ZatharV/ESD-F25-Final_Project/GamePal_PCB/GamePal_PCB_outline.pdf

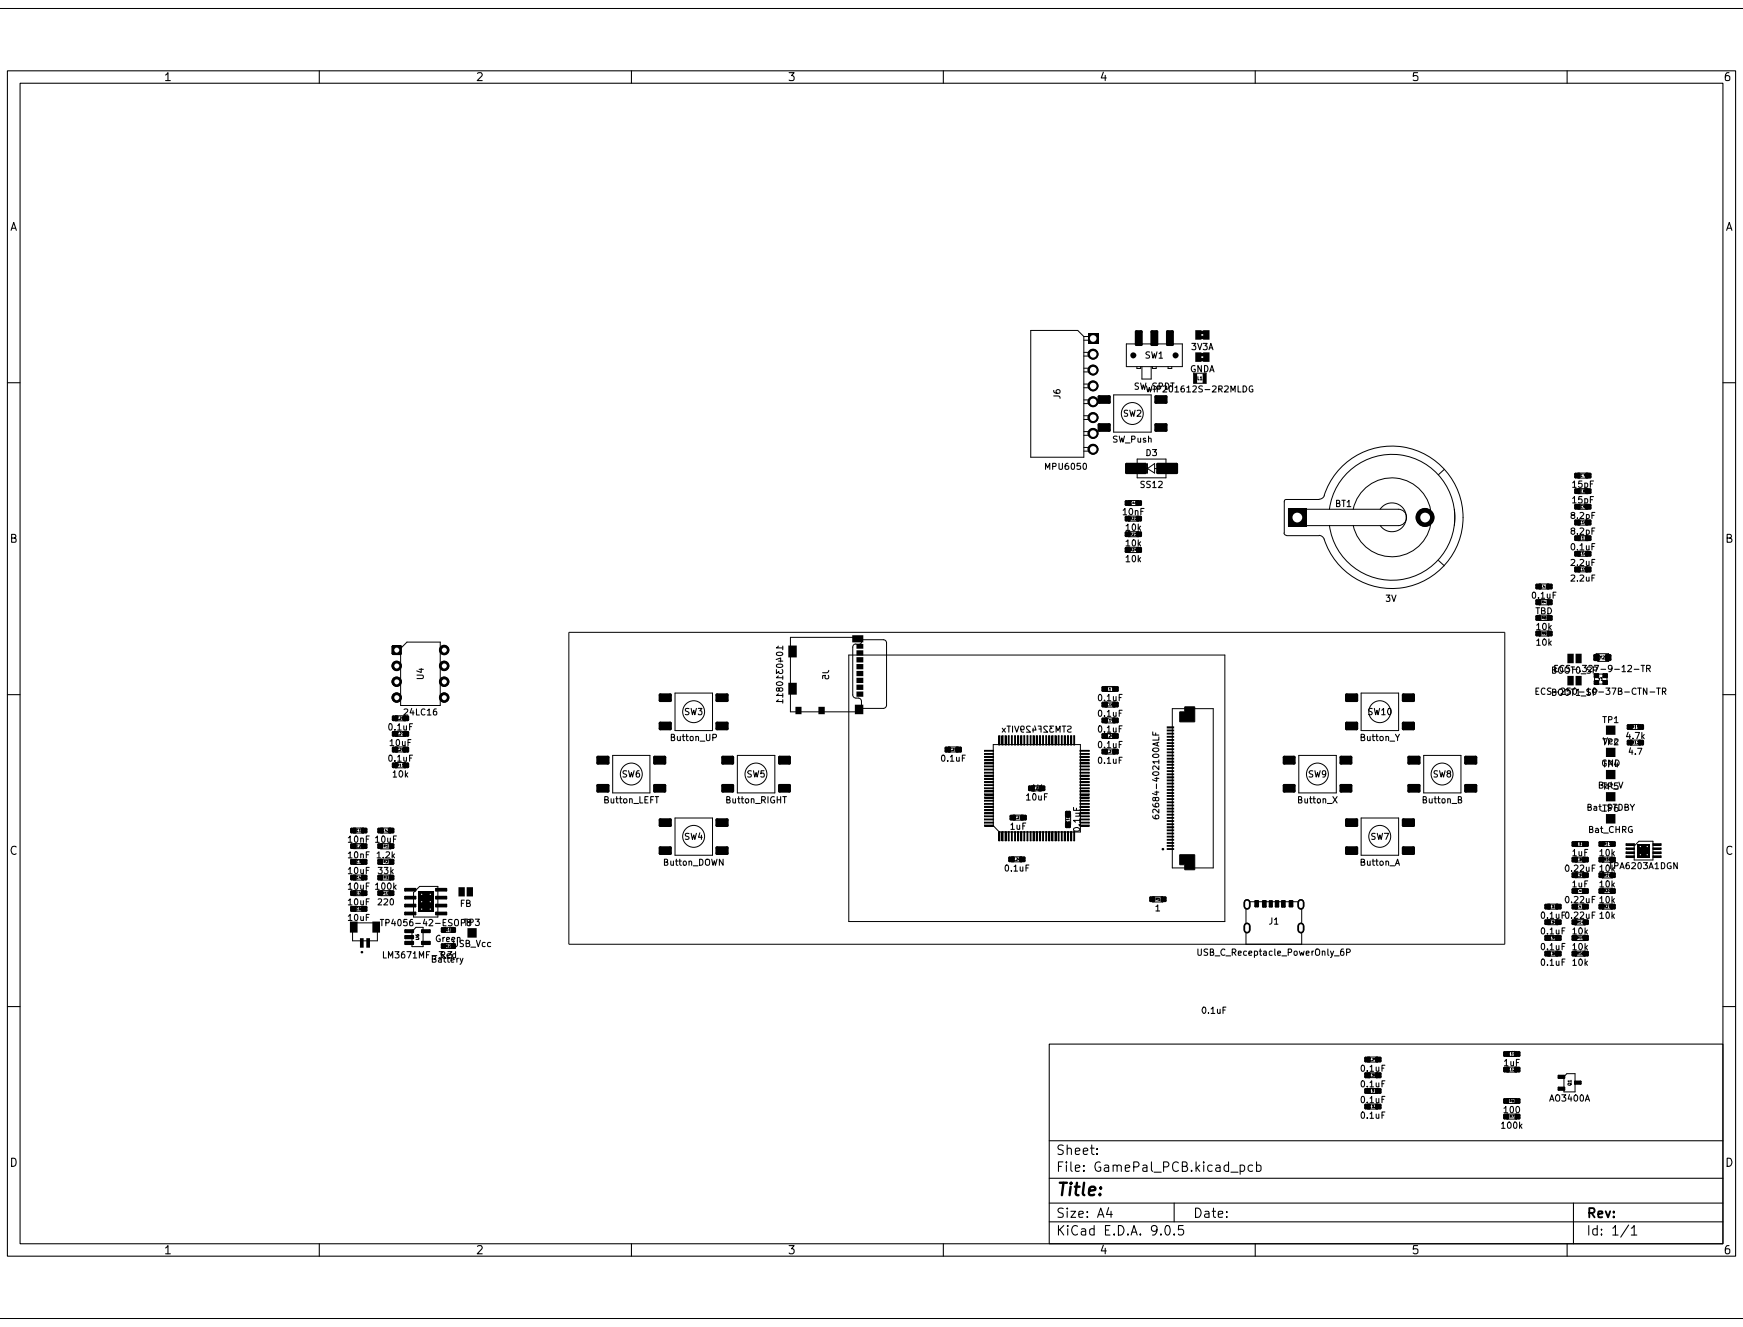
[picture p3: page 1]
