ZatharV/ESD-F25-Final_Project/GamePal_PCB/PDF/GamePal_PCB-Edge_Cuts.pdf

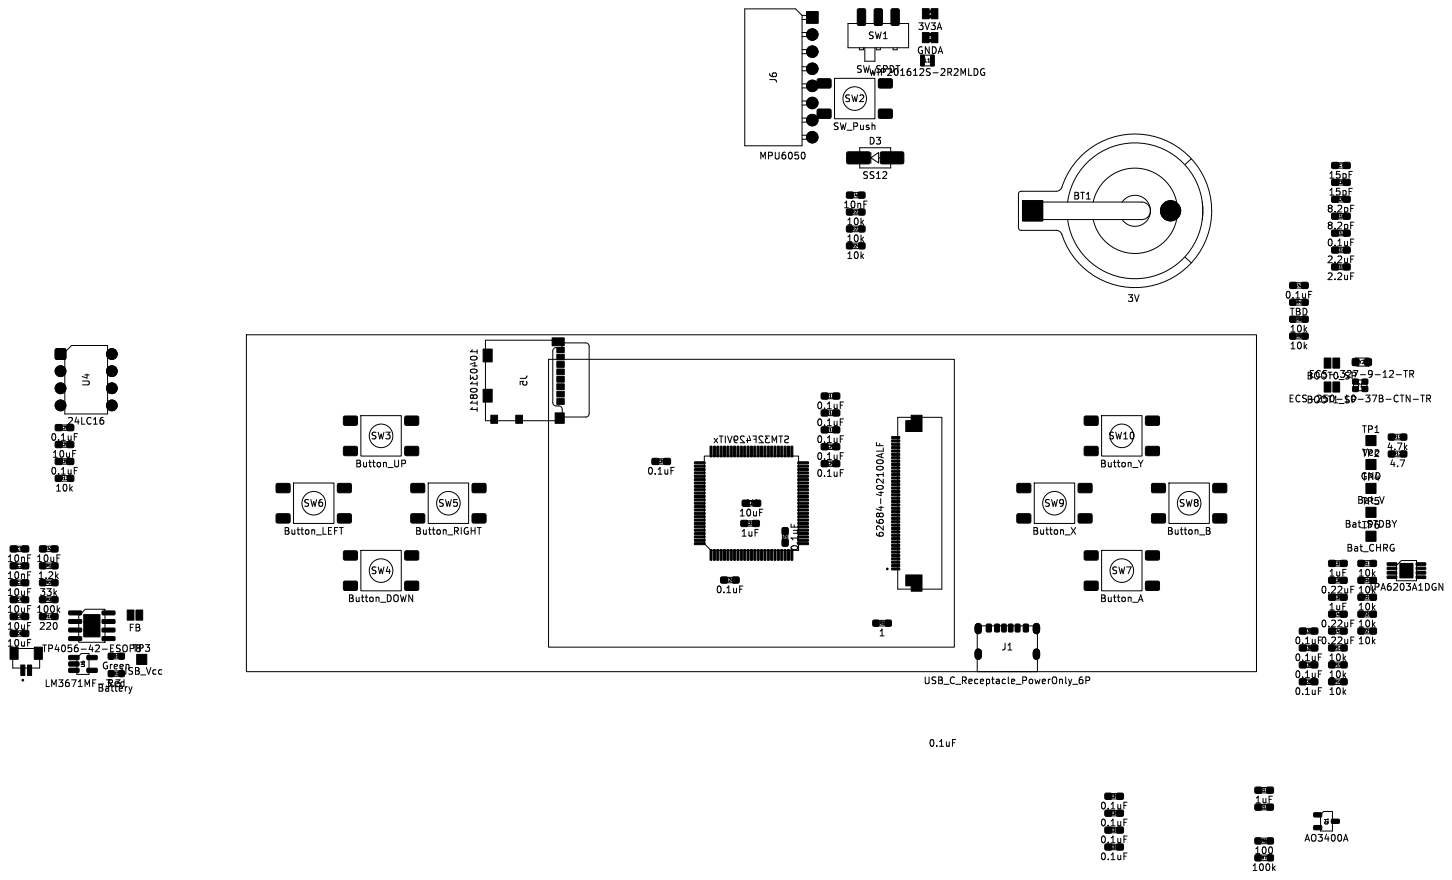
[picture p4: page 1]
