ZatharV/ESD-F25-Final_Project/GamePal_PCB/GamePal_PCB.kicad_pcb

## KiCad design GamePal_PCB/GamePal_PCB.kicad_pcb (2025-11-26)

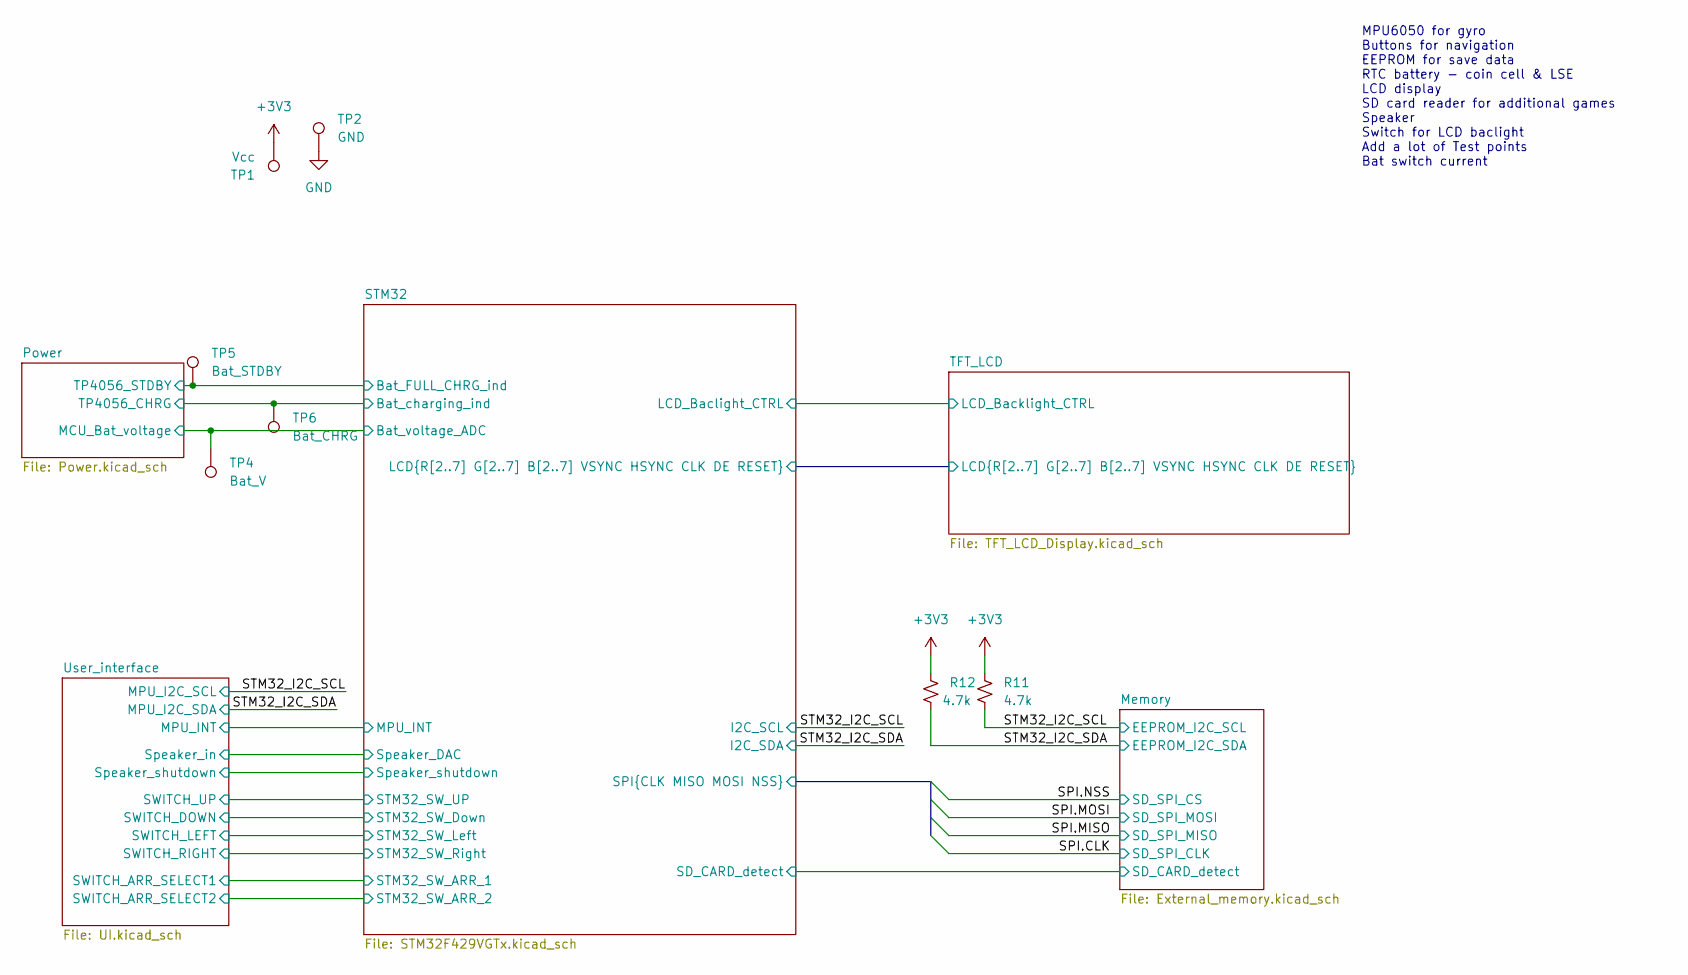
[picture p5: schematic GamePal_PCB.kicad_sch, GamePal]

Parts:
R11, R12: 4.7k; R_0603_1608Metric_Pad0.98x0.95mm_HandSolder
TP1: Vcc; TestPoint_Pad_1.5x1.5mm
TP2: GND; TestPoint_Pad_1.5x1.5mm
TP4: Bat_V; TestPoint_Pad_1.5x1.5mm
TP5: Bat_STDBY; TestPoint_Pad_1.5x1.5mm
TP6: Bat_CHRG; TestPoint_Pad_1.5x1.5mm

Connections:
+3V3: R11.1, R12.1, TP1.1; also elsewhere on the board
/Power/MCU_Bat_voltage: TP4.1; also elsewhere on the board
/Power/TP4056_CHRG: TP6.1; also elsewhere on the board
/Power/TP4056_STDBY: TP5.1; also elsewhere on the board
/STM32_I2C_SCL: R11.2; also elsewhere on the board
/STM32_I2C_SDA: R12.2; also elsewhere on the board
GND: TP2.1; also elsewhere on the board

Notes on the sheet:
MPU6050 for gyro Buttons for navigation EEPROM for save data RTC battery - coin cell & LSE LCD display SD card reader for additional games Speaker Switch for LCD baclight Add a lot of Test points Bat switch current

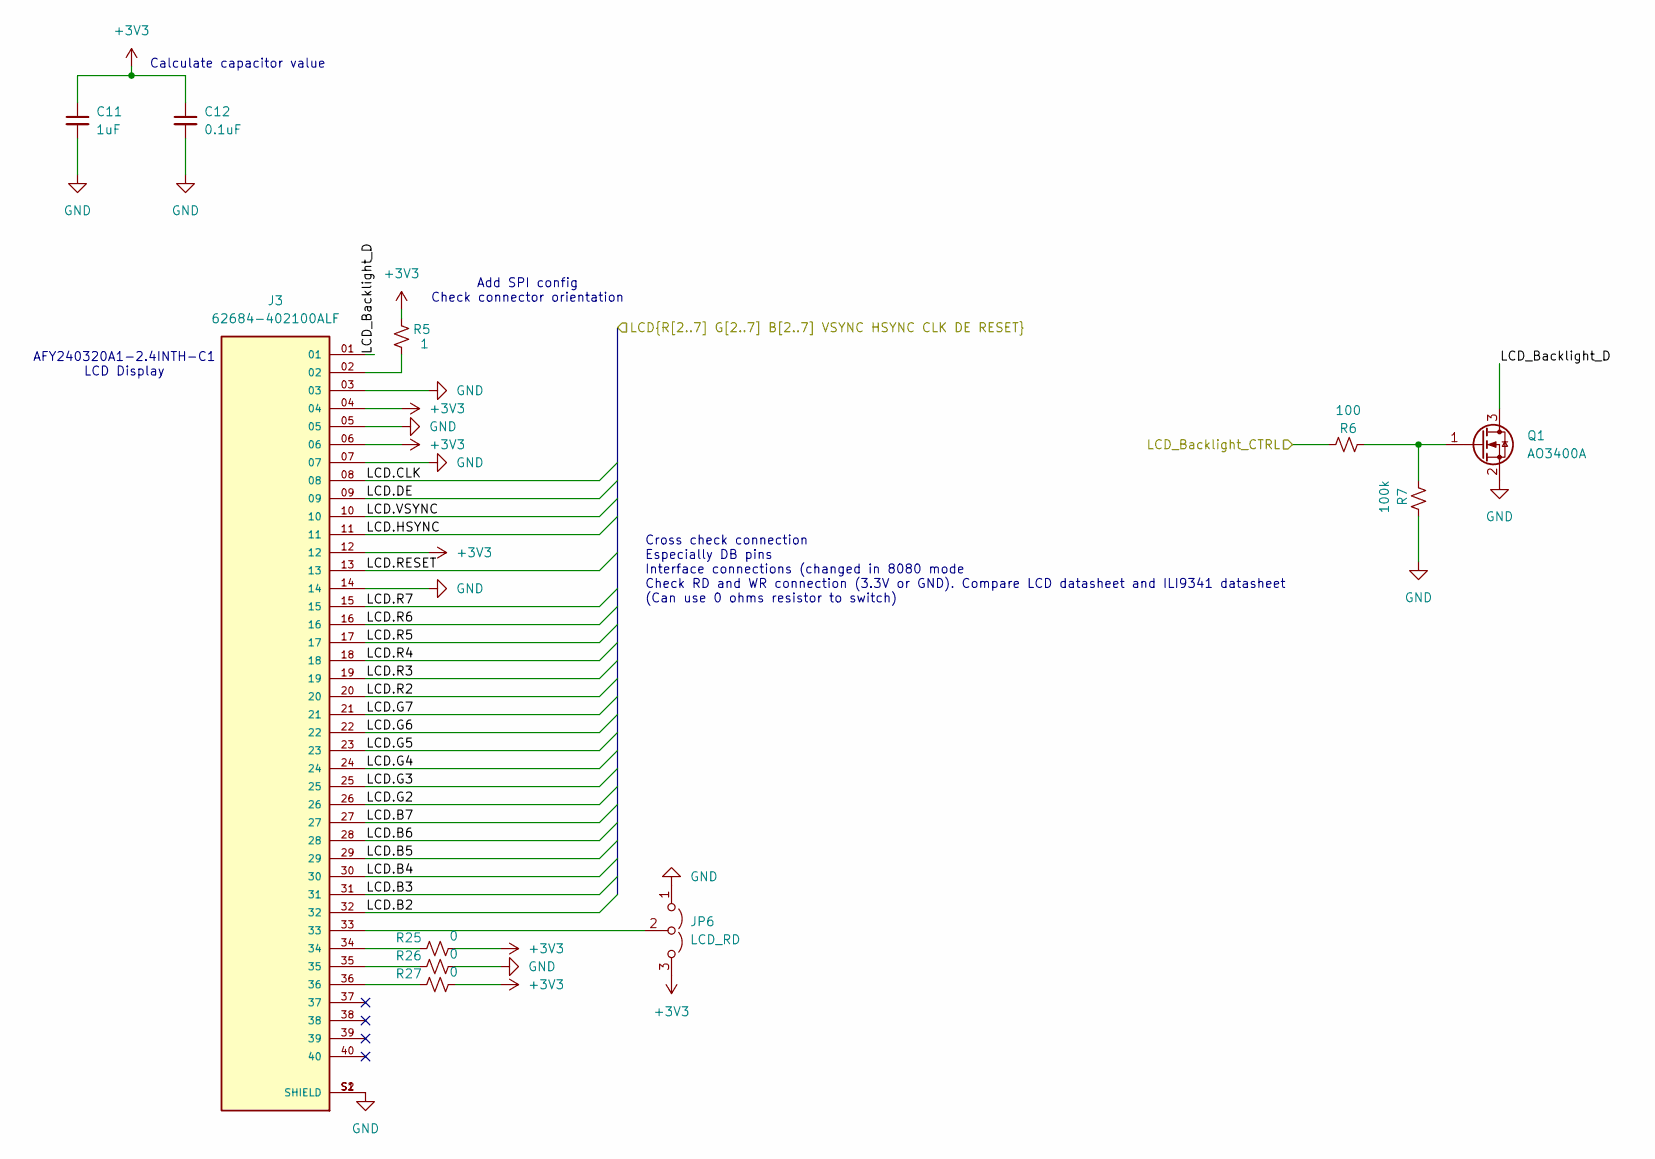
[picture p6: schematic TFT_LCD_Display.kicad_sch, GamePal]

Parts:
C11: 1uF; C_0603_1608Metric_Pad1.08x0.95mm_HandSolder
C12: 0.1uF; C_0603_1608Metric_Pad1.08x0.95mm_HandSolder
J3: 62684-402100ALF; AMPHENOL_62684-402100ALF; PARTREV AK
JP6: LCD_RD; SolderJumper-3_P1.3mm_Open_Pad1.0x1.5mm
Q1: AO3400A; TSOT-23
R5: 1; R_0603_1608Metric_Pad0.98x0.95mm_HandSolder
R6: 100; R_0603_1608Metric_Pad0.98x0.95mm_HandSolder
R7: 100k; R_0603_1608Metric_Pad0.98x0.95mm_HandSolder
R25, R26, R27: 0; R_0603_1608Metric_Pad0.98x0.95mm_HandSolder

Connections:
+3V3: C11.1, C12.1, J3.04, J3.06, J3.12, JP6.3 (B), R5.1, R25.2, R27.2; also elsewhere on the board
/STM32/LCD.B2: J3.32; also elsewhere on the board
/STM32/LCD.B3: J3.31; also elsewhere on the board
/STM32/LCD.B4: J3.30; also elsewhere on the board
/STM32/LCD.B5: J3.29; also elsewhere on the board
/STM32/LCD.B6: J3.28; also elsewhere on the board
/STM32/LCD.B7: J3.27; also elsewhere on the board
/STM32/LCD.CLK: J3.08; also elsewhere on the board
/STM32/LCD.DE: J3.09; also elsewhere on the board
/STM32/LCD.G2: J3.26; also elsewhere on the board
/STM32/LCD.G3: J3.25; also elsewhere on the board
/STM32/LCD.G4: J3.24; also elsewhere on the board
/STM32/LCD.G5: J3.23; also elsewhere on the board
/STM32/LCD.G6: J3.22; also elsewhere on the board
/STM32/LCD.G7: J3.21; also elsewhere on the board
/STM32/LCD.HSYNC: J3.11; also elsewhere on the board
/STM32/LCD.R2: J3.20; also elsewhere on the board
/STM32/LCD.R3: J3.19; also elsewhere on the board
/STM32/LCD.R4: J3.18; also elsewhere on the board
/STM32/LCD.R5: J3.17; also elsewhere on the board
/STM32/LCD.R6: J3.16; also elsewhere on the board
/STM32/LCD.R7: J3.15; also elsewhere on the board
/STM32/LCD.RESET: J3.13; also elsewhere on the board
/STM32/LCD.VSYNC: J3.10; also elsewhere on the board
/STM32/LCD_Baclight_CTRL: R6.1; also elsewhere on the board
/TFT_LCD/LCD_Backlight_D: J3.01, Q1.3 (D)
GND: C11.2, C12.2, J3.03, J3.05, J3.07, J3.14, J3.S1 (SHIELD), J3.S2 (SHIELD), JP6.1 (A), Q1.2 (S), R7.1, R26.2; also elsewhere on the board
unnamed: J3.02, R5.2
unnamed: J3.34, R25.1
unnamed: J3.35, R26.1
unnamed: J3.36, R27.1
unnamed: J3.33, JP6.2 (C)
unnamed: Q1.1 (G), R6.2, R7.2

Notes on the sheet:
AFY240320A1-2.4INTH-C1 LCD Display
Cross check connection Especially DB pins Interface connections (changed in 8080 mode Check RD and WR connection (3.3V or GND). Compare LCD datasheet and ILI9341 datasheet (Can use 0 ohms resistor to switch)
Add SPI config Check connector orientation
Calculate capacitor value

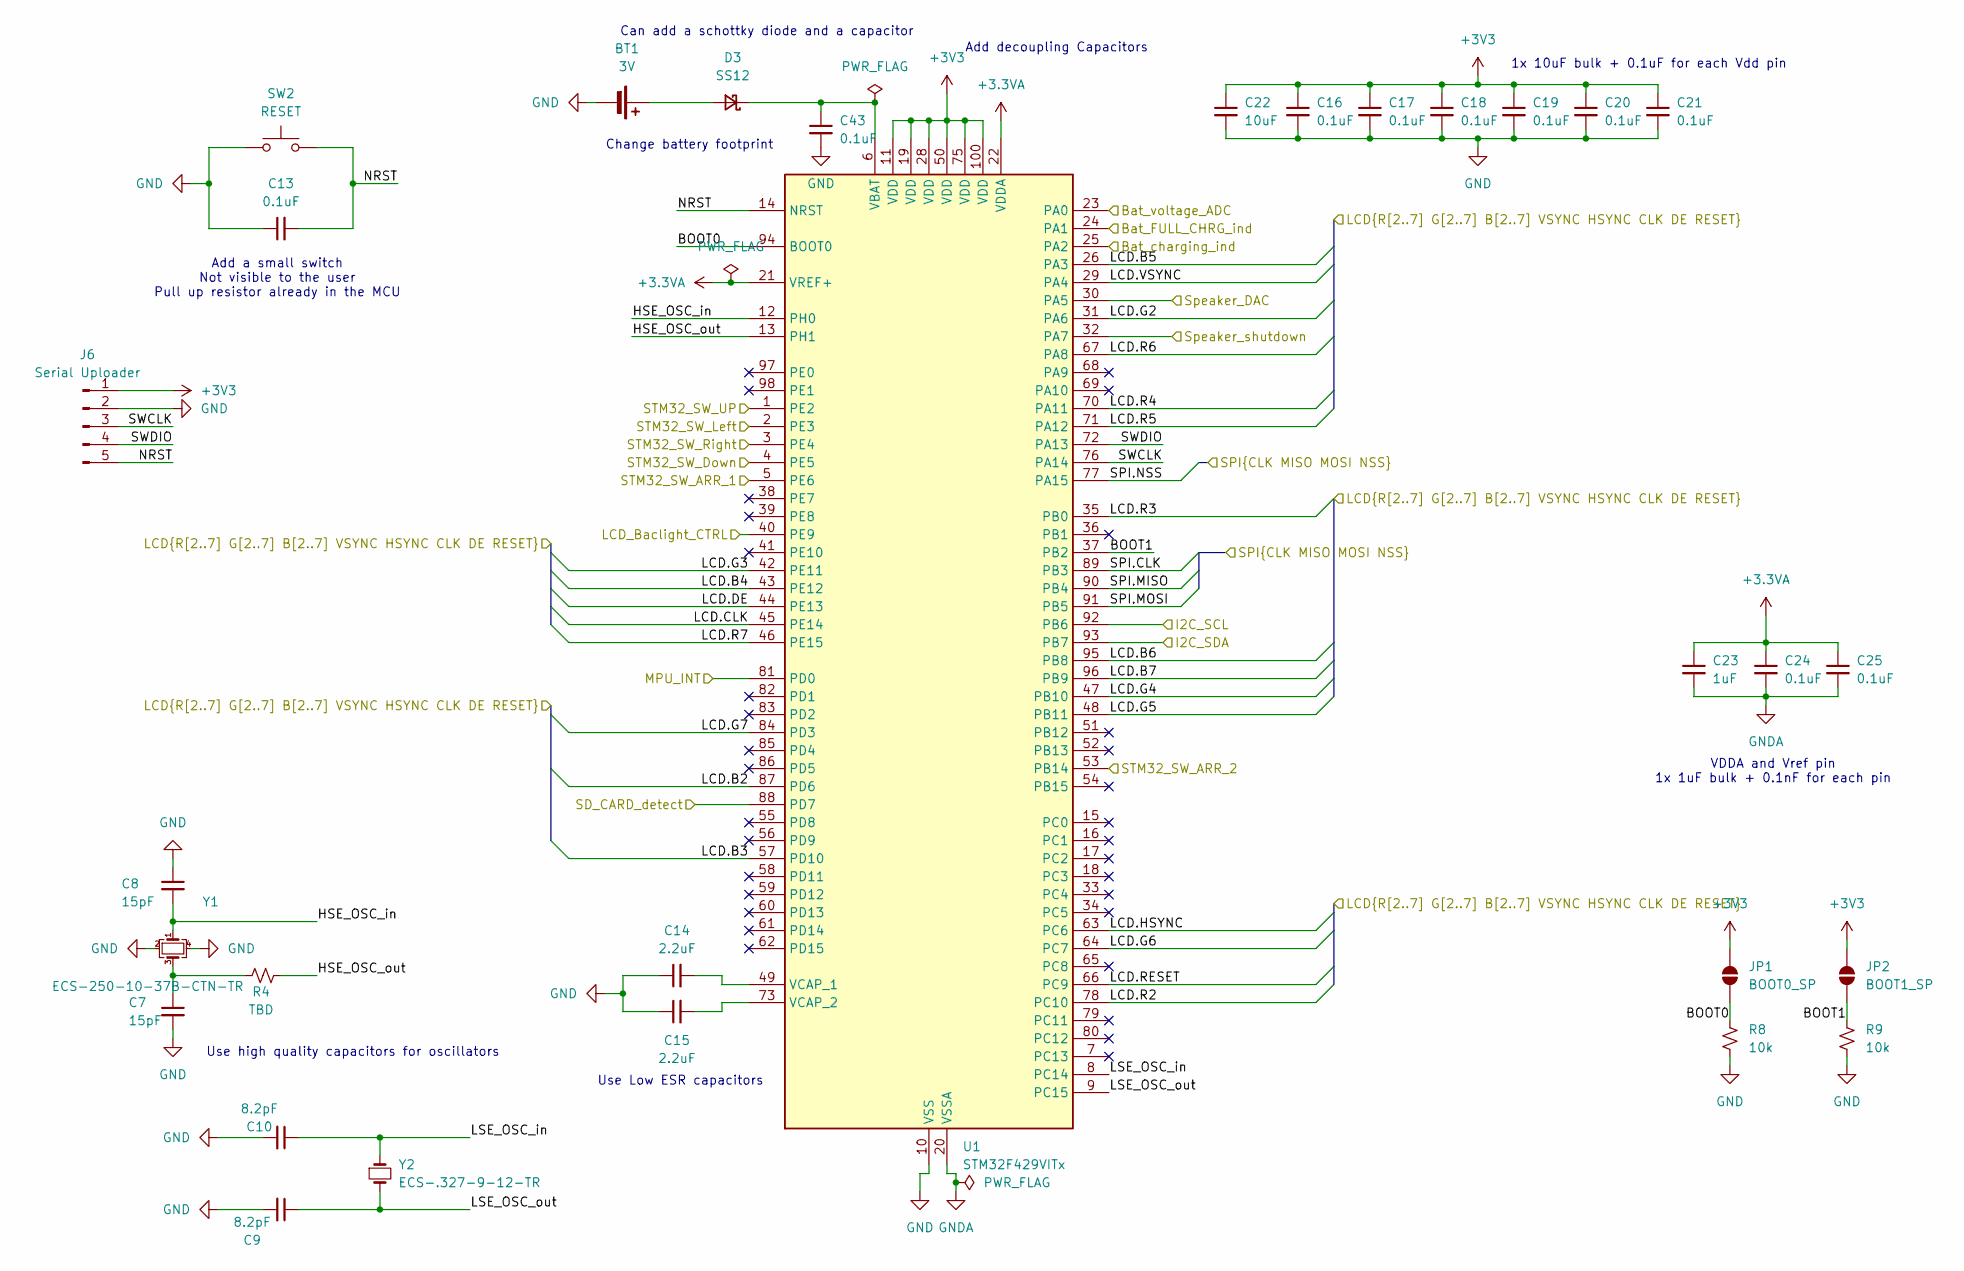
[picture p7: schematic STM32F429VGTx.kicad_sch, GamePal]

Parts:
BT1: 3V; BatteryHolder_Seiko_MS621F
C7, C8: 15pF; C_0603_1608Metric_Pad1.08x0.95mm_HandSolder
C9, C10: 8.2pF; C_0603_1608Metric_Pad1.08x0.95mm_HandSolder
C13, C16, C17, C18, C19, C20, C21, C24, C25, C43: 0.1uF; C_0603_1608Metric_Pad1.08x0.95mm_HandSolder
C14, C15: 2.2uF; C_0603_1608Metric_Pad1.08x0.95mm_HandSolder
C22: 10uF; C_0603_1608Metric_Pad1.08x0.95mm_HandSolder
C23: 1uF; C_0603_1608Metric_Pad1.08x0.95mm_HandSolder
D3: SS12; D_SMA
J6: Serial Uploader; PinHeader_1x05_P2.54mm_Vertical_SMD_Pin1Right
JP1: BOOT0_SP; SolderJumper-2_P1.3mm_Open_Pad1.0x1.5mm
JP2: BOOT1_SP; SolderJumper-2_P1.3mm_Open_Pad1.0x1.5mm
R4: TBD; R_0603_1608Metric_Pad0.98x0.95mm_HandSolder
R8, R9: 10k; R_0603_1608Metric_Pad0.98x0.95mm_HandSolder
SW2: RESET; SW_Push_1P1T_NO_CK_KMR2
U1: STM32F429VITx; LQFP-100_14x14mm_P0.5mm
Y1: ECS-250-10-37B-CTN-TR; Crystal_SMD_2016-4Pin_2.0x1.6mm
Y2: ECS-.327-9-12-TR; Crystal_SMD_2012-2Pin_2.0x1.2mm_HandSoldering

Connections:
+3.3VA: C23.1, C24.1, C25.1, U1.21 (VREF+), U1.22 (VDDA); also elsewhere on the board
+3V3: C16.1, C17.1, C18.1, C19.1, C20.1, C21.1, C22.1, J6.1, JP1.2 (B), JP2.2 (B), U1.11 (VDD), U1.19 (VDD), U1.28 (VDD), U1.50 (VDD), U1.75 (VDD), U1.100 (VDD); also elsewhere on the board
/Memory/SD_CARD_detect: U1.88 (PD7); also elsewhere on the board
/Power/MCU_Bat_voltage: U1.23 (PA0); also elsewhere on the board
/Power/TP4056_CHRG: U1.25 (PA2); also elsewhere on the board
/Power/TP4056_STDBY: U1.24 (PA1); also elsewhere on the board
/STM32/BOOT0: JP1.1 (A), R8.1, U1.94 (BOOT0)
/STM32/BOOT1: JP2.1 (A), R9.1, U1.37 (PB2)
/STM32/HSE_OSC_in: C8.2, U1.12 (PH0), Y1.1
/STM32/HSE_OSC_out: R4.1, U1.13 (PH1)
/STM32/LCD.B2: U1.87 (PD6); also elsewhere on the board
/STM32/LCD.B3: U1.57 (PD10); also elsewhere on the board
/STM32/LCD.B4: U1.43 (PE12); also elsewhere on the board
/STM32/LCD.B5: U1.26 (PA3); also elsewhere on the board
/STM32/LCD.B6: U1.95 (PB8); also elsewhere on the board
/STM32/LCD.B7: U1.96 (PB9); also elsewhere on the board
/STM32/LCD.CLK: U1.45 (PE14); also elsewhere on the board
/STM32/LCD.DE: U1.44 (PE13); also elsewhere on the board
/STM32/LCD.G2: U1.31 (PA6); also elsewhere on the board
/STM32/LCD.G3: U1.42 (PE11); also elsewhere on the board
/STM32/LCD.G4: U1.47 (PB10); also elsewhere on the board
/STM32/LCD.G5: U1.48 (PB11); also elsewhere on the board
/STM32/LCD.G6: U1.64 (PC7); also elsewhere on the board
/STM32/LCD.G7: U1.84 (PD3); also elsewhere on the board
/STM32/LCD.HSYNC: U1.63 (PC6); also elsewhere on the board
/STM32/LCD.R2: U1.78 (PC10); also elsewhere on the board
/STM32/LCD.R3: U1.35 (PB0); also elsewhere on the board
/STM32/LCD.R4: U1.70 (PA11); also elsewhere on the board
/STM32/LCD.R5: U1.71 (PA12); also elsewhere on the board
/STM32/LCD.R6: U1.67 (PA8); also elsewhere on the board
/STM32/LCD.R7: U1.46 (PE15); also elsewhere on the board
/STM32/LCD.RESET: U1.66 (PC9); also elsewhere on the board
/STM32/LCD.VSYNC: U1.29 (PA4); also elsewhere on the board
/STM32/LCD_Baclight_CTRL: U1.40 (PE9); also elsewhere on the board
/STM32/LSE_OSC_in: C10.1, U1.8 (PC14), Y2.1
/STM32/LSE_OSC_out: C9.1, U1.9 (PC15), Y2.2
/STM32/MPU_INT: U1.81 (PD0); also elsewhere on the board
/STM32/NRST: C13.2, J6.5, SW2.2, U1.14 (NRST)
/STM32/SPI.CLK: U1.89 (PB3); also elsewhere on the board
/STM32/SPI.MISO: U1.90 (PB4); also elsewhere on the board
/STM32/SPI.MOSI: U1.91 (PB5); also elsewhere on the board
/STM32/SPI.NSS: U1.77 (PA15); also elsewhere on the board
/STM32/STM32_SW_ARR_1: U1.5 (PE6); also elsewhere on the board
/STM32/STM32_SW_ARR_2: U1.53 (PB14); also elsewhere on the board
/STM32/STM32_SW_Down: U1.4 (PE5); also elsewhere on the board
/STM32/STM32_SW_Left: U1.2 (PE3); also elsewhere on the board
/STM32/STM32_SW_Right: U1.3 (PE4); also elsewhere on the board
/STM32/STM32_SW_UP: U1.1 (PE2); also elsewhere on the board
/STM32/SWCLK: J6.3, U1.76 (PA14)
/STM32/SWDIO: J6.4, U1.72 (PA13)
/STM32/Speaker_DAC: U1.30 (PA5); also elsewhere on the board
/STM32/Speaker_shutdown: U1.32 (PA7); also elsewhere on the board
/STM32_I2C_SCL: U1.92 (PB6); also elsewhere on the board
/STM32_I2C_SDA: U1.93 (PB7); also elsewhere on the board
GND: BT1.2 (-), C7.2, C8.1, C9.2, C10.2, C13.1, C14.1, C15.1, C16.2, C17.2, C18.2, C19.2, C20.2, C21.2, C22.2, C43.2, J6.2, R8.2, R9.2, SW2.1, U1.10 (VSS), U1.27 (VSS), U1.74 (VSS), U1.99 (VSS), Y1.2, Y1.4; also elsewhere on the board
GNDA: C23.2, C24.2, C25.2, U1.20 (VSSA); also elsewhere on the board
unnamed: BT1.1 (+), D3.2 (A)
unnamed: C7.1, R4.2, Y1.3
unnamed: C43.1, D3.1 (K), U1.6 (VBAT)
unnamed: C14.2, U1.49 (VCAP_1)
unnamed: C15.2, U1.73 (VCAP_2)

Notes on the sheet:
1x 10uF bulk + 0.1uF for each Vdd pin
Use Low ESR capacitors
VDDA and Vref pin 1x 1uF bulk + 0.1nF for each pin
Can add a schottky diode and a capacitor
Add a small switch Not visible to the user Pull up resistor already in the MCU
Use high quality capacitors for oscillators
Change battery footprint
Add decoupling Capacitors

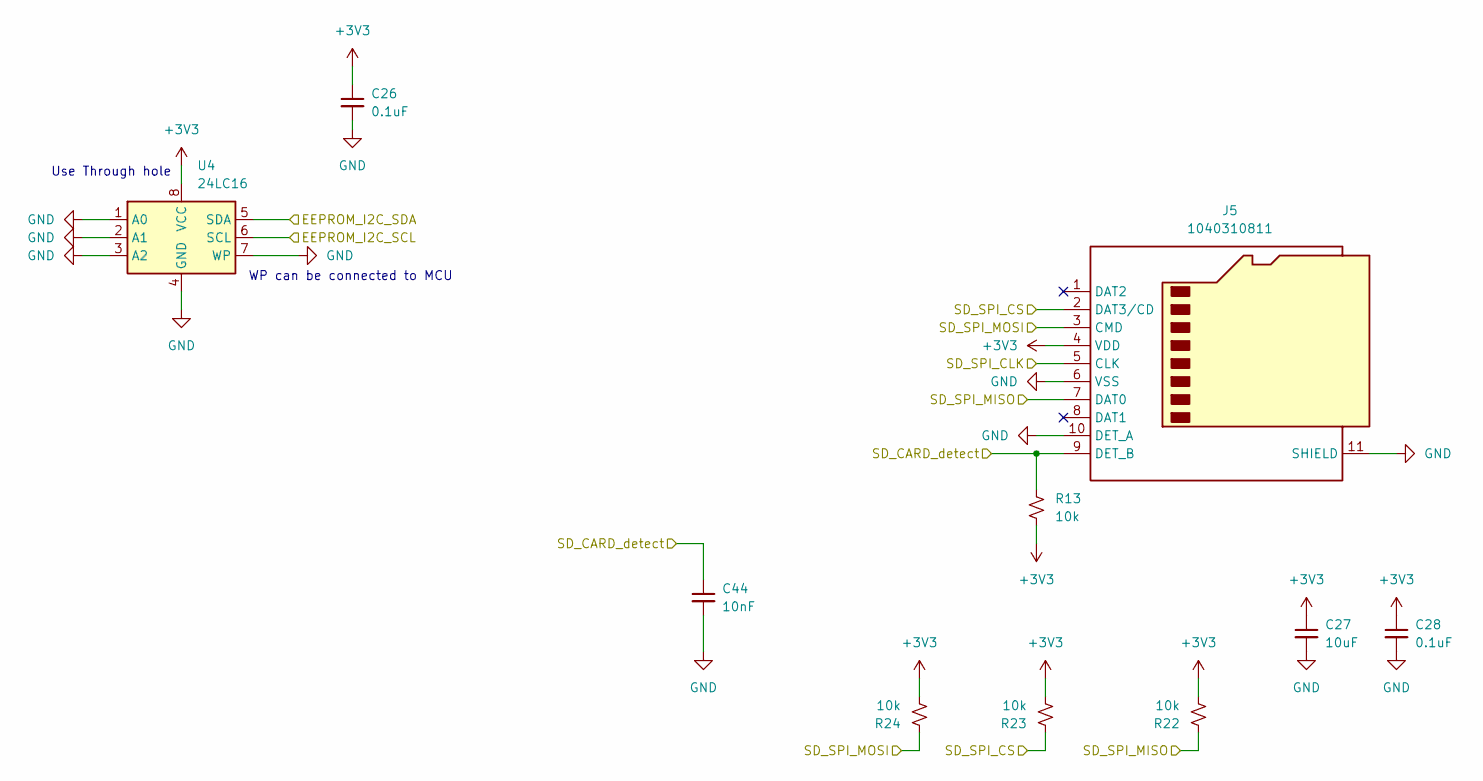
[picture p8: schematic External_memory.kicad_sch, GamePal]

Parts:
C26, C28: 0.1uF; C_0603_1608Metric_Pad1.08x0.95mm_HandSolder
C27: 10uF; C_0603_1608Metric_Pad1.08x0.95mm_HandSolder
C44: 10nF; C_0603_1608Metric_Pad1.08x0.95mm_HandSolder
J5: 1040310811; microSD_HC_Molex_104031-0811
R13, R22, R23, R24: 10k; R_0603_1608Metric_Pad0.98x0.95mm_HandSolder
U4: 24LC16; DIP-8_W7.62mm

Connections:
+3V3: C26.1, C27.1, C28.1, J5.4 (VDD), R13.1, R22.1, R23.1, R24.1, U4.8 (VCC); also elsewhere on the board
/Memory/SD_CARD_detect: C44.1, J5.9 (DET_B), R13.2; also elsewhere on the board
/STM32/SPI.CLK: J5.5 (CLK); also elsewhere on the board
/STM32/SPI.MISO: J5.7 (DAT0), R22.2; also elsewhere on the board
/STM32/SPI.MOSI: J5.3 (CMD), R24.2; also elsewhere on the board
/STM32/SPI.NSS: J5.2 (DAT3/CD), R23.2; also elsewhere on the board
/STM32_I2C_SCL: U4.6 (SCL); also elsewhere on the board
/STM32_I2C_SDA: U4.5 (SDA); also elsewhere on the board
GND: C26.2, C27.2, C28.2, C44.2, J5.6 (VSS), J5.10 (DET_A), J5.11 (SHIELD), U4.1 (A0), U4.2 (A1), U4.3 (A2), U4.4 (GND), U4.7 (WP); also elsewhere on the board

Notes on the sheet:
WP can be connected to MCU
Use Through hole

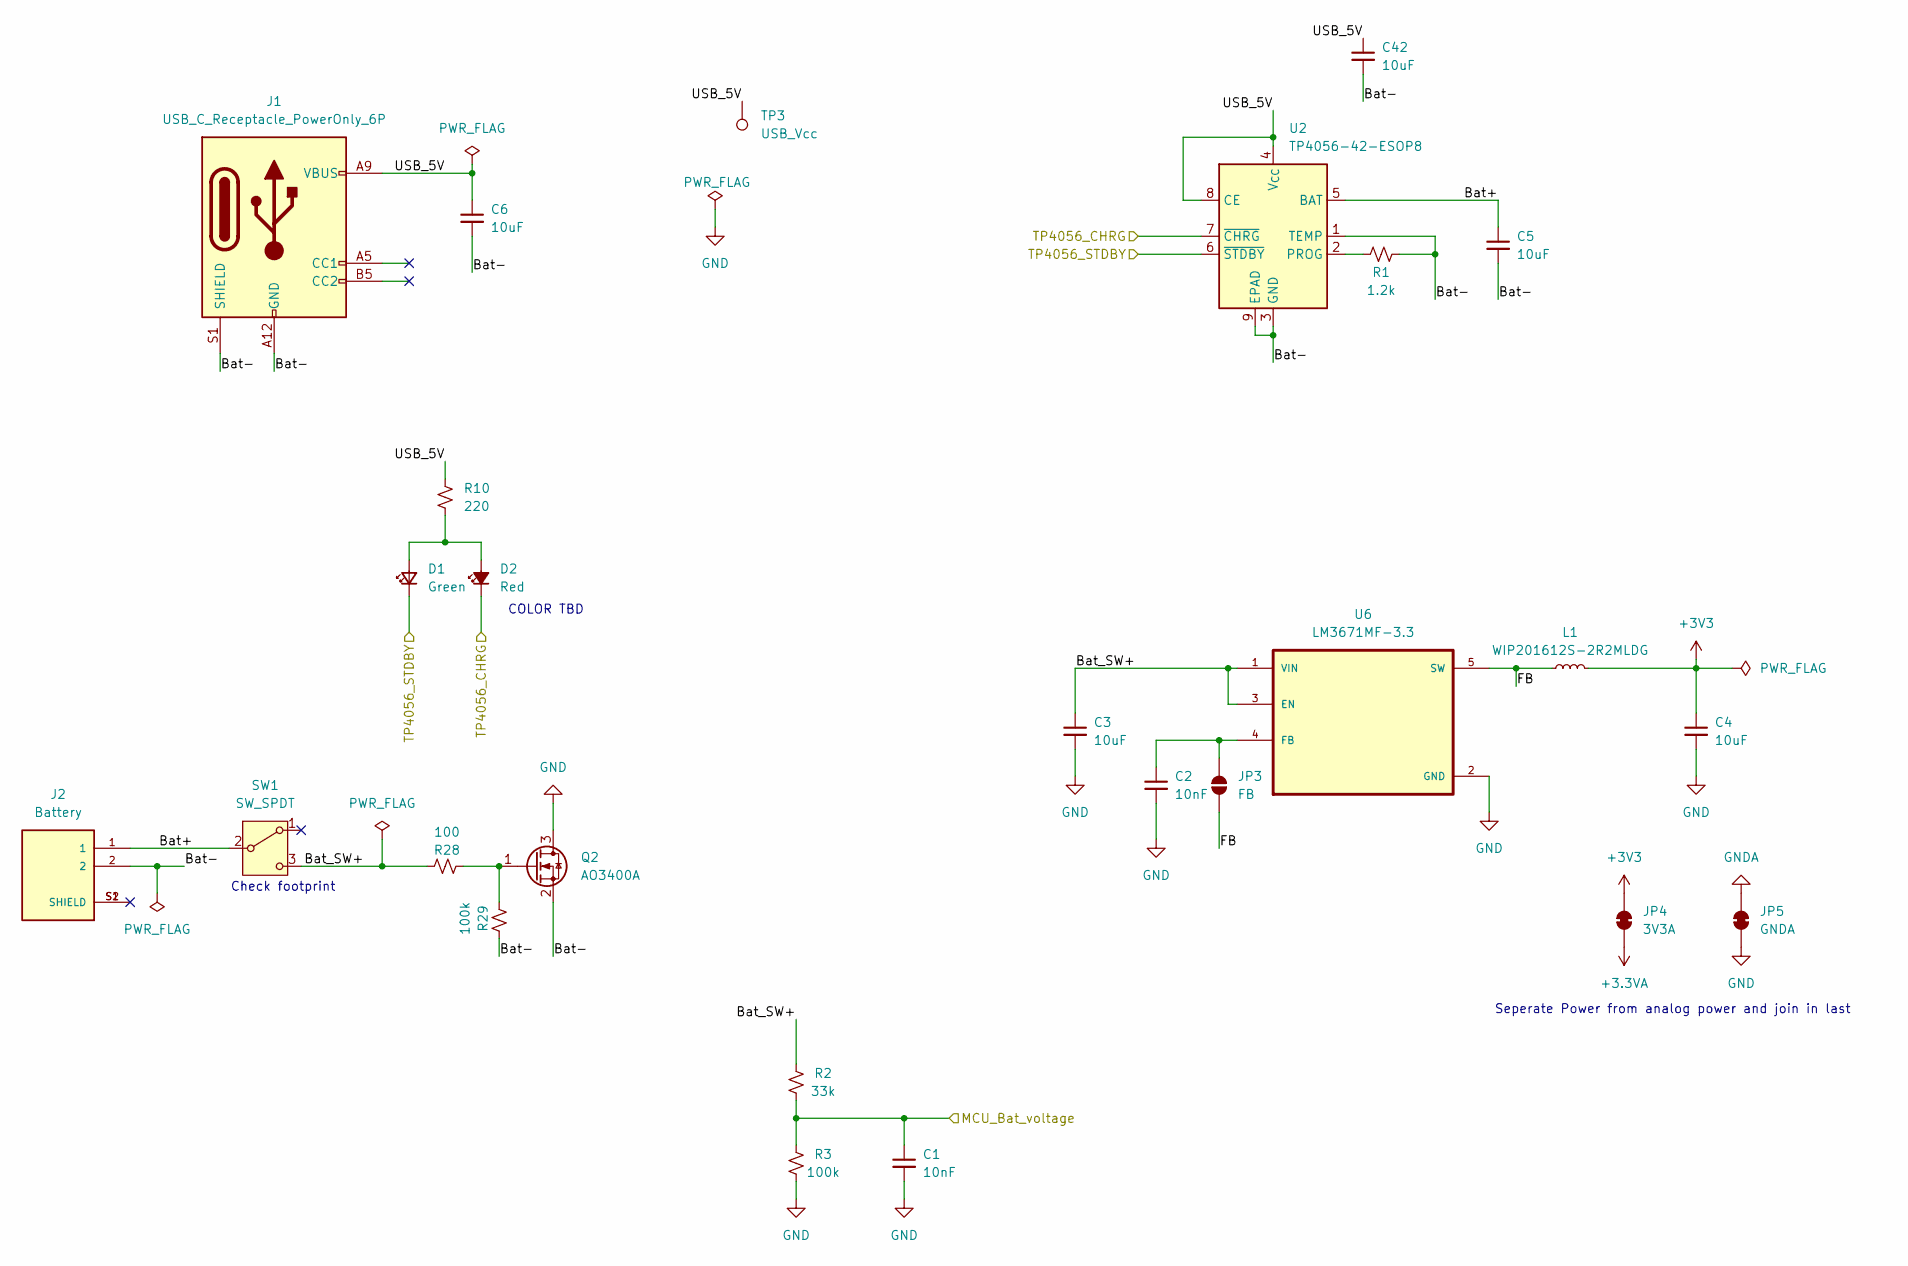
[picture p9: schematic Power.kicad_sch, GamePal]

Parts:
C1, C2: 10nF; C_0603_1608Metric_Pad1.08x0.95mm_HandSolder
C3, C4, C5, C6, C42: 10uF; C_0603_1608Metric_Pad1.08x0.95mm_HandSolder
D1: Green; LED_0603_1608Metric
D2: Red; LED_0603_1608Metric
J1: USB_C_Receptacle_PowerOnly_6P; USB_C_Receptacle_GCT_USB4125-xx-x_6P_TopMnt_Horizontal
J2: Battery; JST_BM02B-SRSS-TB_LF__SN_; PARTREV N/A
JP3: FB; SolderJumper-2_P1.3mm_Open_Pad1.0x1.5mm
JP4: 3V3A; SolderJumper-2_P1.3mm_Bridged2Bar_Pad1.0x1.5mm
JP5: GNDA; SolderJumper-2_P1.3mm_Bridged2Bar_Pad1.0x1.5mm
L1: WIP201612S-2R2MLDG; L_Murata_DFE201610P
Q2: AO3400A; TSOT-23
R1: 1.2k; R_0603_1608Metric_Pad0.98x0.95mm_HandSolder
R2: 33k; R_0603_1608Metric_Pad0.98x0.95mm_HandSolder
R3, R29: 100k; R_0603_1608Metric_Pad0.98x0.95mm_HandSolder
R10: 220; R_0603_1608Metric_Pad0.98x0.95mm_HandSolder
R28: 100; R_0603_1608Metric_Pad0.98x0.95mm_HandSolder
SW1: SW_SPDT; SW_SPDT_CK_JS102011SAQN
TP3: USB_Vcc; TestPoint_Pad_1.5x1.5mm
U2: TP4056-42-ESOP8; MSOP-8-1EP_3x3mm_P0.65mm_EP1.95x2.15mm
U6: LM3671MF-3.3; SOT-23-5_HandSoldering

Connections:
+3.3VA: JP4.1 (A); also elsewhere on the board
+3V3: C4.1, JP4.2 (B), L1.2; also elsewhere on the board
/Power/Bat+: C5.1, J2.1, SW1.2 (B), U2.5 (BAT)
/Power/Bat-: C5.2, C6.2, C42.2, J1.A12 (GND), J1.B12 (GND), J1.S1 (SHIELD), J2.2, Q2.2 (S), R1.1, R29.1, U2.1 (TEMP), U2.3 (GND), U2.9 (EPAD)
/Power/Bat_SW+: C3.1, R2.1, R28.1, SW1.3 (C), U6.1 (VIN), U6.3 (EN)
/Power/FB: JP3.1 (A), L1.1, U6.5 (SW)
/Power/MCU_Bat_voltage: C1.1, R2.2, R3.1; also elsewhere on the board
/Power/TP4056_CHRG: D2.1 (K), U2.7 (~CHRG); also elsewhere on the board
/Power/TP4056_STDBY: D1.1 (K), U2.6 (~STDBY); also elsewhere on the board
/Power/USB_5V: C6.1, C42.1, J1.A9 (VBUS), J1.B9 (VBUS), R10.1, TP3.1, U2.4 (V_{CC}), U2.8 (CE)
GND: C1.2, C2.2, C3.2, C4.2, JP5.1 (A), Q2.3 (D), R3.2, U6.2 (GND); also elsewhere on the board
GNDA: JP5.2 (B); also elsewhere on the board
unnamed: D1.2 (A), D2.2 (A), R10.2
unnamed: C2.1, JP3.2 (B), U6.4 (FB)
unnamed: Q2.1 (G), R28.2, R29.2
unnamed: R1.2, U2.2 (PROG)

Notes on the sheet:
Seperate Power from analog power and join in last
Check footprint
COLOR TBD

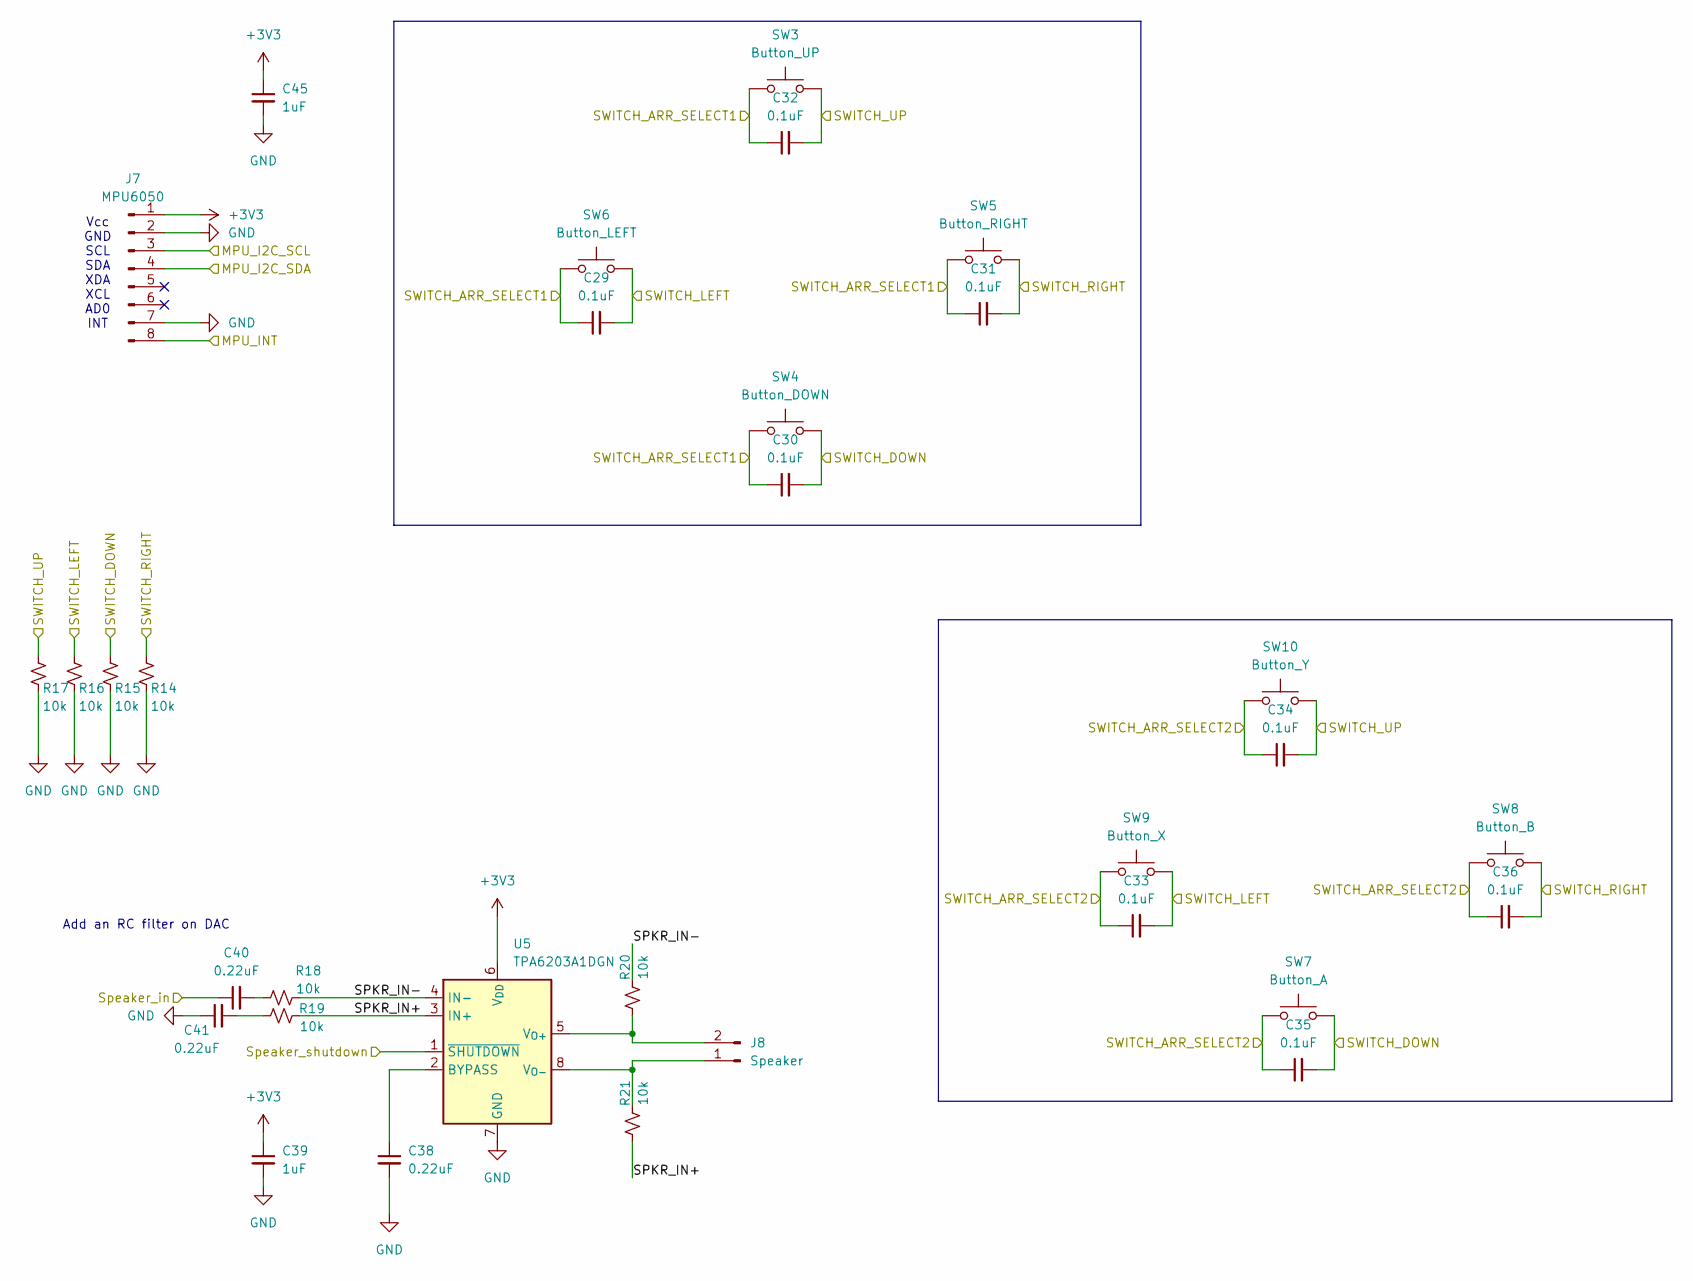
[picture p10: schematic UI.kicad_sch, GamePal]

Parts:
C29, C30, C31, C32, C33, C34, C35, C36: 0.1uF; C_0603_1608Metric_Pad1.08x0.95mm_HandSolder
C38, C40, C41: 0.22uF; C_0603_1608Metric_Pad1.08x0.95mm_HandSolder
C39, C45: 1uF; C_0603_1608Metric_Pad1.08x0.95mm_HandSolder
J7: MPU6050; module_mpu6050
J8: Speaker; PinHeader_1x02_P2.54mm_Vertical_SMD_Pin1Left
R14, R15, R16, R17, R18, R19, R20, R21: 10k; R_0603_1608Metric_Pad0.98x0.95mm_HandSolder
SW3: Button_UP; SW_Push_1P1T_NO_E-Switch_TL3301NxxxxxG
SW4: Button_DOWN; SW_Push_1P1T_NO_E-Switch_TL3301NxxxxxG
SW5: Button_RIGHT; SW_Push_1P1T_NO_E-Switch_TL3301NxxxxxG
SW6: Button_LEFT; SW_Push_1P1T_NO_E-Switch_TL3301NxxxxxG
SW7: Button_A; SW_Push_1P1T_NO_E-Switch_TL3301NxxxxxG
SW8: Button_B; SW_Push_1P1T_NO_E-Switch_TL3301NxxxxxG
SW9: Button_X; SW_Push_1P1T_NO_E-Switch_TL3301NxxxxxG
SW10: Button_Y; SW_Push_1P1T_NO_E-Switch_TL3301NxxxxxG
U5: TPA6203A1DGN; MSOP-8-1EP_3x3mm_P0.65mm_EP1.95x2.15mm

Connections:
+3V3: C39.1, C45.1, J7.1, U5.6 (V_{DD}); also elsewhere on the board
/STM32/MPU_INT: J7.8; also elsewhere on the board
/STM32/STM32_SW_ARR_1: C29.1, C30.1, C31.1, C32.1, SW3.1, SW4.1, SW5.1, SW6.1; also elsewhere on the board
/STM32/STM32_SW_ARR_2: C33.1, C34.1, C35.1, C36.1, SW7.1, SW8.1, SW9.1, SW10.1; also elsewhere on the board
/STM32/STM32_SW_Down: C30.2, C35.2, R15.1, SW4.2, SW7.2; also elsewhere on the board
/STM32/STM32_SW_Left: C29.2, C33.2, R16.1, SW6.2, SW9.2; also elsewhere on the board
/STM32/STM32_SW_Right: C31.2, C36.2, R14.1, SW5.2, SW8.2; also elsewhere on the board
/STM32/STM32_SW_UP: C32.2, C34.2, R17.1, SW3.2, SW10.2; also elsewhere on the board
/STM32/Speaker_DAC: C40.1; also elsewhere on the board
/STM32/Speaker_shutdown: U5.1 (~SHUTDOWN); also elsewhere on the board
/STM32_I2C_SCL: J7.3; also elsewhere on the board
/STM32_I2C_SDA: J7.4; also elsewhere on the board
/User_interface/SPKR_IN+: R19.2, R21.1, U5.3 (IN+)
/User_interface/SPKR_IN-: R18.2, R20.2, U5.4 (IN-)
GND: C38.2, C39.2, C41.1, C45.2, J7.2, J7.7, R14.2, R15.2, R16.2, R17.2, U5.7 (GND), U5.9 (GND); also elsewhere on the board
unnamed: C40.2, R18.1
unnamed: C41.2, R19.1
unnamed: J8.1, R21.2, U5.8 (V_{O-})
unnamed: J8.2, R20.1, U5.5 (V_{O+})
unnamed: C38.1, U5.2 (BYPASS)

Notes on the sheet:
Vcc GND SCL SDA XDA XCL AD0 INT
Add an RC filter on DAC

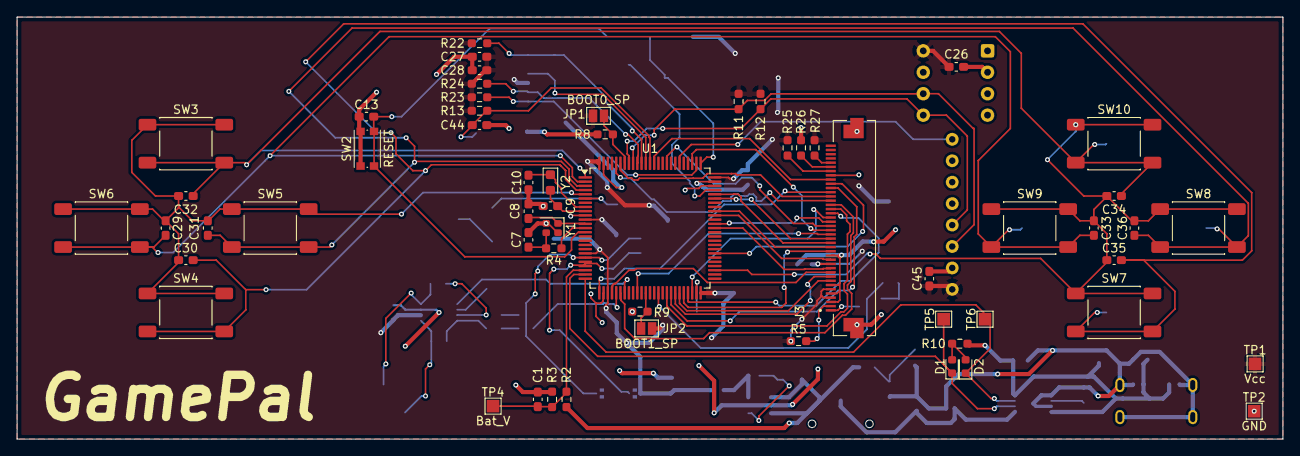
[picture p11: board GamePal_PCB.kicad_pcb from above]

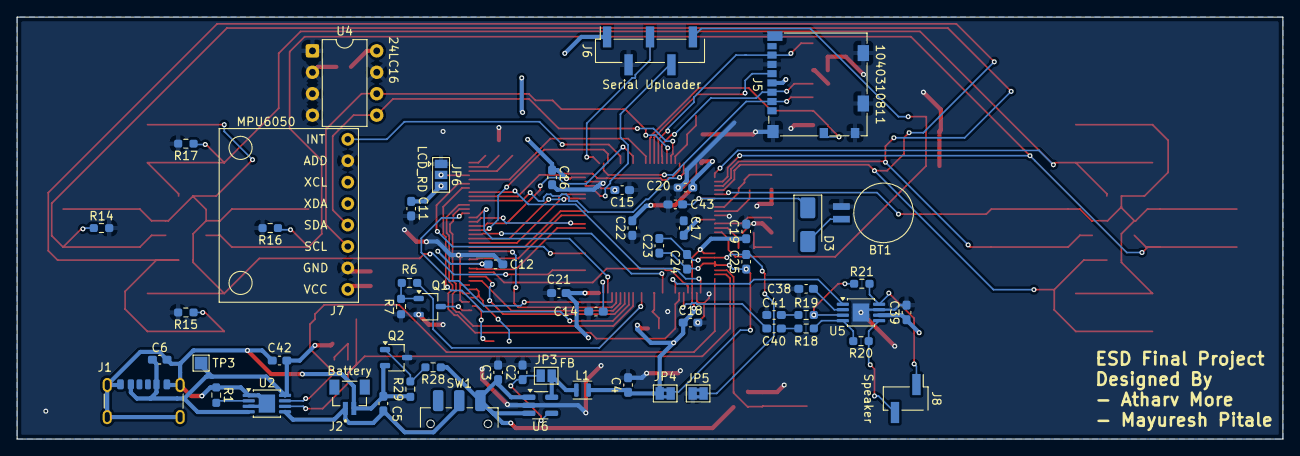
[picture p12: board GamePal_PCB.kicad_pcb from below]

Board: 2 copper layers, 150.0 x 50.0 mm, 116 parts (59 on the bottom side), 84 nets.
