ZatharV/ESD-F25-Final_Project/GamePal_STM32/Core/Src/main.c

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
/* Includes ------------------------------------------------------------------*/
#include "main.h"

/* USER CODE BEGIN Includes */
#include "TFT_LCD.h"
#include "st7789v.h"
#include "User_Interface.h"
#include "Games/T_rex/T_rex.h"
#include "Games/Snake_game/Snake_game.h"

/* USER CODE END Includes */

/* USER CODE BEGIN PTD */

typedef enum 
{
  GAME_SNAKE = 0,
  GAME_DINO_JUMP = 1
} GameList_t;

/* USER CODE END PTD */

/* USER CODE BEGIN PD */
#define Display_Game_List_Text_pos_x	10
#define Display_Game_List_Text_pos_y	10

#define LCD_BG_COLOR              0xFFFF
#define LCD_MENU_TEXT_COLOR	      0x0000
#define LCD_MENU_HIGHLIGHT_COLOR  0xFFE0

#define LCD_MENU_TEXT_FONT       &Font16
#define LCD_MENU_HEADER_FONT     &Font20

#define TOTAL_GAMES              2

/* USER CODE END PD */

LTDC_HandleTypeDef hltdc;

SPI_HandleTypeDef hspi3;
DMA_HandleTypeDef hdma_spi3_rx;
DMA_HandleTypeDef hdma_spi3_tx;

TIM_HandleTypeDef htim1;

/* USER CODE BEGIN PV */

GameList_t game_select_ind = 0;
uint8_t game_selected = 0;

/* USER CODE END PV */

void SystemClock_Config(void);
static void MX_GPIO_Init(void);
static void MX_DMA_Init(void);
static void MX_SPI3_Init(void);
static void MX_LTDC_Init(void);
static void MX_TIM1_Init(void);
/* USER CODE BEGIN PFP */
void display_game_list();
void select_game();

/* USER CODE END PFP */

/**
  * @brief  The application entry point.
  * @retval int
  */
int main(void)
{

  /* MCU Configuration--------------------------------------------------------*/

  /* Reset of all peripherals, Initializes the Flash interface and the Systick. */
  HAL_Init();

  /* Configure the system clock */
  SystemClock_Config();

  /* Initialize all configured peripherals */
  MX_GPIO_Init();
  MX_DMA_Init();
  MX_SPI3_Init();
  MX_LTDC_Init();
  MX_TIM1_Init();
  /* USER CODE BEGIN 2 */

  // LCD Display Backlight On
  HAL_TIM_PWM_Start(&htim1, TIM_CHANNEL_1);

  // Reload LTDC configuration
  HAL_LTDC_Reload(&hltdc,LTDC_SRCR_VBR);

  LCD_clear_screen();

  /* USER CODE END 2 */

  /* Infinite loop */
  /* USER CODE BEGIN WHILE */
  while (1)
  {
    /* USER CODE END WHILE */

    /* USER CODE BEGIN 3 */
	
    // Select Game from the Game List
    select_game();

	if(game_select_ind == GAME_SNAKE)
	{
		snake_gamePlay();
		game_selected = 0;
	}
	else if(game_select_ind == GAME_DINO_JUMP)
	{
		T_rex_main();
		game_selected = 0;
	}
  }
  /* USER CODE END 3 */
}

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
/* USER CODE BEGIN 4 */

/**
 * @brief Displays the game list on LCD display
 * 
 */
void display_game_list()
{
  // Display Header
	uint16_t bg = LCD_BG_COLOR;
	LCD_Display_Text(Display_Game_List_Text_pos_x, Display_Game_List_Text_pos_y, "Select the game", LCD_MENU_TEXT_COLOR, bg, LCD_MENU_HEADER_FONT);

  // Display Game Options
  bg = (game_select_ind == 0) ? (LCD_MENU_HIGHLIGHT_COLOR) : (LCD_BG_COLOR);
	LCD_Display_Text(Display_Game_List_Text_pos_x, Display_Game_List_Text_pos_y + 20, "Snake Game", LCD_MENU_TEXT_COLOR, bg, LCD_MENU_TEXT_FONT);
  
  bg = (game_selected == 1) ? (LCD_MENU_HIGHLIGHT_COLOR) : (LCD_MENU_TEXT_COLOR);
	LCD_Display_Text(Display_Game_List_Text_pos_x, Display_Game_List_Text_pos_y + 40, "Dino Jump Game", LCD_MENU_TEXT_COLOR, bg, LCD_MENU_TEXT_FONT);
}

/**
 * @brief Selects Game from the game list on LCD display
 * 
 */
void select_game()
{
	LCD_clear_screen();

  // Wait on the menu until a game is selected
	while(!game_selected)
	{
		display_game_list();  // Update game list display
		read_switch();        // Read switch states
		
    if(SW_A)
		{
      // If Pressed A button, select the game
			game_selected = 1;
		}
		else if(SW_up)
		{
      // Navigate the game list
			if(game_select_ind == 0)
        game_select_ind = TOTAL_GAMES - 1;
      else
        game_select_ind--;
		}
    else if (SW_down)
    {
      // Navigate the game list
      if(game_select_ind == TOTAL_GAMES - 1)
        game_select_ind = 0;
      else
        game_select_ind++;
    }
		HAL_Delay(200);
	}
}

/* USER CODE END 4 */
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
