ZatharV/ESD-F25-Final_Project/GamePal_STM32/GamePal_STM32.ioc

Mcu.UserName=STM32F429VGTx
PA11.Signal=LTDC_R4
PA12.Signal=LTDC_R5
PA13.Signal=SYS_JTMS-SWDIO
PA14.Signal=SYS_JTCK-SWCLK
PA15.GPIO_Label=SD_CS
PA15.Signal=GPIO_Output
PA3.Signal=LTDC_B5
PA4.Signal=LTDC_VSYNC
PA6.Signal=LTDC_G2
PA8.Signal=LTDC_R6
PB0.Signal=LTDC_R3
PB10.Signal=LTDC_G4
PB11.Signal=LTDC_G5
PB14.GPIO_Label=SW_ARR_2
PB14.Signal=GPIO_Output
PB3.Signal=SPI3_SCK
PB4.Signal=SPI3_MISO
PB5.Signal=SPI3_MOSI
PB6.GPIO_Label=LCD_WRX
PB6.Signal=GPIO_Output
PB8.Signal=LTDC_B6
PB9.Signal=LTDC_B7
PC6.Signal=LTDC_HSYNC
PC7.Signal=LTDC_G6
PC9.GPIO_Label=LCD_RESET
PC9.Signal=GPIO_Output
PD0.GPIO_Label=LCD_CS
PD0.Signal=GPIO_Output
PD10.Signal=LTDC_B3
PD3.Signal=LTDC_G7
PE11.Signal=LTDC_G3
PE12.Signal=LTDC_B4
PE13.Signal=LTDC_DE
PE14.Signal=LTDC_CLK
PE15.Signal=LTDC_R7
PE2.GPIO_Label=SW_UP
PE2.Signal=GPIO_Output
PE3.GPIO_Label=SW_LEFT
PE3.Signal=GPIO_Output
PE4.GPIO_Label=SW_RIGHT
PE4.Signal=GPIO_Output
PE5.GPIO_Label=SW_DOWN
PE5.Signal=GPIO_Output
PE6.GPIO_Label=SW_ARR_1
PE6.Signal=GPIO_Output
PE9.GPIO_Label=LCD_BL
PE9.Signal=S_TIM1_CH1
