ZatharV/ESD-F25-Final_Project/GamePal_STM32/Core/Inc/Games/T_rex/Images.h

/*
 * Images.h
 * 
 * This file contains the raw images data and length for T-rex game.
 * The images are stored as arrays in RGB565 color format. 
 * All the images are stored in flash memory to save RAM space.
 * 
 *  Created on: Dec 4, 2025
 *      Author: Atharv More
 * 		Modified by: Mayuresh Pitale
 */

#ifndef INC_IMAGES_H_
#define INC_IMAGES_H_

#include "stdint.h"

#define dino_jump_width 25
#define dino_jump_height 27

#define dino_start_width 97
#define dino_start_height 101

#define dino_run1_width	43
#define dino_run1_height 47

#define dino_run2_width 44
#define dino_run2_height 47

#define dino_track_width	320
#define dino_track_height	4

#define dino_cactus_width	24
#define dino_cactus_height	47

static const uint16_t dino_cactus_img[dino_cactus_width * dino_cactus_height] = {0xffff, 0xffff, 0xffff, 0xffff, 0xffff, 0xffff, 0xffff, 0xffff, 0xffff, 0xffff, 0xffff, 0xffdf, 0xffff, 0xffff, 0xffdf, 0xffff, 0xffff, 0xffff, 0xffff, 0xffff, 0xffff, 0xffff, 0xffff, 0xffff,
		0xffff, 0xffff, 0xffff, 0xffff, 0xffff, 0xffff, 0xffff, 0xffff, 0xf7be, 0xf7be, 0xf79e, 0xf79e, 0xf7be, 0xf7be, 0xffff, 0xffff, 0xffff, 0xffff, 0xffff, 0xffff, 0xffff, 0xffff, 0xffff, 0xffff,
		0xffff, 0xffff, 0xffff, 0xffff, 0xffff, 0xffff, 0xffff, 0xffdf, 0xf7be, 0x52aa, 0x528a, 0x52aa, 0x528a, 0x528a, 0xf79e, 0xf7be, 0xffff, 0xffff, 0xffff, 0xffff, 0xffff, 0xffff, 0xffff, 0xffff,
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
xffff, 0xc618, 0xdefb, 0x52aa, 0x9cf3, 0xbdf7, 0xdedb, 0xc638, 0xa534, 0x8c71, 0xce79, 0xffff, 0xffff, 0xffff, 0xffff, 0xffff, 0xffff, 0xffff, 0xffff, 0xffff, 0xffff, 0xffff, 0xffff, 0xffff, 0xffff, 0xffdf, 0xc638, 0xdefb, 0x528a, 0xce59, 0xc618, 0xef7d, 0xbdf7, 0xad55, 0x8410, 0xb596, 0xce79, 0xffff, 0xffff, 0xffff, 0xffff, 0xffff, 0xffff, 0xffff, 0xffff, 0xffff, 0xffff, 0xffff, 0xffff, 0xffff, 0xffff, 0xce59, 0xd6ba, 0x6b6d, 0x6b4d, 0xf79e, 0xd69a, 0xce59, 0xad55, 0x6b4d, 0x9492, 0xe73c, 0xffff, 0xffff, 0xffff, 0xffff, 0xffff, 0xffff, 0xffff, 0xffff, 0xffff, 0xffff, 0xffff, 0xffff, 0xffdf, 0xffff, 0xc638, 0xffff, 0xf79e, 0xffdf, 0xf79e, 0xd69a, 0xc618, 0xf7be, 0xffdf, 0xf79e, 0xe71c, 0xffff, 0xffff, 0xffff, 0xffff, 0xffff, 0xffff, 0xffff, 0xffff, 0xffff};


#endif /* INC_IMAGES_H_ */
