ZatharV/ESD-F25-Final_Project/GamePal_STM32/Core/Inc/TFT_LCD.h

/*
 * TFT-LCD.h
 *
 * Include this file to use the TFT LCD functions.
 * It contains the LCD matrix which updates the LCD display.
 * Supports special LCD functions.
 *
 *  Created on: Nov 21, 2025
 *      Author: Atharv More
 *      Modified by: Mayuresh Pitale
 */

#ifndef INC_TFT_LCD_H_
#define INC_TFT_LCD_H_

#include "Fonts/fonts.h"
#include "stdint.h"

#define LCD_WIDTH	320
#define LCD_HEIGHT	240

#define LCD_array_size	(LCD_WIDTH * LCD_HEIGHT)

#define RGB565_WHITE_COLOR	0xFFFF
#define RGB565_BLACK_COLOR	0x0000

extern uint16_t LCD_screen_matrix[LCD_array_size];

void update_LCD_matrix(uint16_t x_pos, uint16_t y_pos, uint16_t color);
void LCD_Display_Text(uint16_t x_pos, uint16_t y_pos, char *text, uint16_t color, uint16_t bgcolor, sFONT* Font);
void LCD_clear_screen();


#endif /* INC_TFT_LCD_H_ */
