ZatharV/ESD-F25-Final_Project/GamePal_STM32/Core/Inc/User_Interface.h

/*
 * User_Interface.h
 *
 * Include this file to use the User Interface functions.
 * It contains the function to read the switch states.
 * You can read the states of the switches.
 *
 *  Created on: Dec 5, 2025
 *      Author: Atharv More
 *      Modified by: Mayuresh Pitale
 */

#ifndef INC_USER_INTERFACE_H_
#define INC_USER_INTERFACE_H_

#include "stdint.h"

extern uint8_t SW_up;
extern uint8_t SW_down;
extern uint8_t SW_left;
extern uint8_t SW_right;

extern uint8_t SW_Y;
extern uint8_t SW_X;
extern uint8_t SW_A;
extern uint8_t SW_B;


void read_switch();

#endif /* INC_USER_INTERFACE_H_ */
