ZatharV/ESD-F25-Final_Project/GamePal-STM32-Test Codes/GamePal_SD_CARD_Test/Core/Inc/main.h

#define SW_UP_Pin GPIO_PIN_2
#define SW_UP_GPIO_Port GPIOE
#define SW_LEFT_Pin GPIO_PIN_3
#define SW_LEFT_GPIO_Port GPIOE
#define SW_RIGHT_Pin GPIO_PIN_4
#define SW_RIGHT_GPIO_Port GPIOE
#define SW_DOWN_Pin GPIO_PIN_5
#define SW_DOWN_GPIO_Port GPIOE
#define SW_ARR_1_Pin GPIO_PIN_6
#define SW_ARR_1_GPIO_Port GPIOE
#define LCD_BL_Pin GPIO_PIN_9
#define LCD_BL_GPIO_Port GPIOE
#define SW_ARR_2_Pin GPIO_PIN_14
#define SW_ARR_2_GPIO_Port GPIOB
#define LCD_RESET_Pin GPIO_PIN_9
#define LCD_RESET_GPIO_Port GPIOC
#define SD_CS_Pin GPIO_PIN_15
#define SD_CS_GPIO_Port GPIOA
#define LCD_CS_Pin GPIO_PIN_0
#define LCD_CS_GPIO_Port GPIOD
#define LCD_WRX_Pin GPIO_PIN_6
#define LCD_WRX_GPIO_Port GPIOB
