ZatharV/ESD-F25-Final_Project/(commit log)

2025-10-29 PCB init commit
    [GamePal_PCB.kicad_pcb, GamePal_PCB.kicad_sch, Power.kicad_sch]
2025-11-03 PCB update
    [GamePal_PCB.kicad_sch, Power.kicad_sch]
2025-11-09 KICAD PCB LCD connections
    [24c16C.kicad_sch, GamePal_PCB.kicad_sch, STM32F429VGTx.kicad_sch, TFT_LCD_Display.kicad_sch]
2025-11-09 Update PCB
    [24c16C.kicad_sch, GamePal_PCB.kicad_sch, Power.kicad_sch, SD_CARD.kicad_sch, STM32F429VGTx.kicad_sch, TFT_LCD_Display.kicad_sch]
2025-11-10 PCB complete (double check all connections)
    [External_memory.kicad_sch, GamePal_PCB.kicad_sch, Power.kicad_sch, SD_CARD.kicad_sch, STM32F429VGTx.kicad_sch, UI.kicad_sch]
2025-11-11 mpu6050 driver
2025-11-18 PCB complete
    [External_memory.kicad_sch, GamePal_PCB.csv, GamePal_PCB.kicad_pcb, GamePal_PCB.kicad_sch, Power.kicad_sch, STM32F429VGTx.kicad_sch, TFT_LCD_Display.kicad_sch, UI.kicad_sch]
2025-11-18 PCB Final version
    [GamePal_PCB.kicad_pcb, TFT_LCD_Display.kicad_sch]
2025-11-18 PCB full and final
    [GamePal_PCB.csv, GamePal_PCB.kicad_pcb, Power.kicad_sch]
2025-11-18 Gerber added
    [GamePal_PCB-B_Cu.gbr, GamePal_PCB-B_Mask.gbr, GamePal_PCB-B_Paste.gbr, GamePal_PCB-B_Silkscreen.gbr, GamePal_PCB-Edge_Cuts.gbr, GamePal_PCB-F_Cu.gbr, GamePal_PCB-F_Mask.gbr, GamePal_PCB-F_Paste.gbr]
2025-11-18 Final PCB design
2025-11-26 added GPIO and battery test
